max96W/class_d_amp/README.md

# Class D amplifier
A discrete class D amplifier able to deliver 300 W into 4 Ohms

For further information please read docu.pdf/odt. Note that the design is not fully tested yet so do not expect it to work out of the box if you like to build it.
