max96W/class_d_amp/classD.pdf

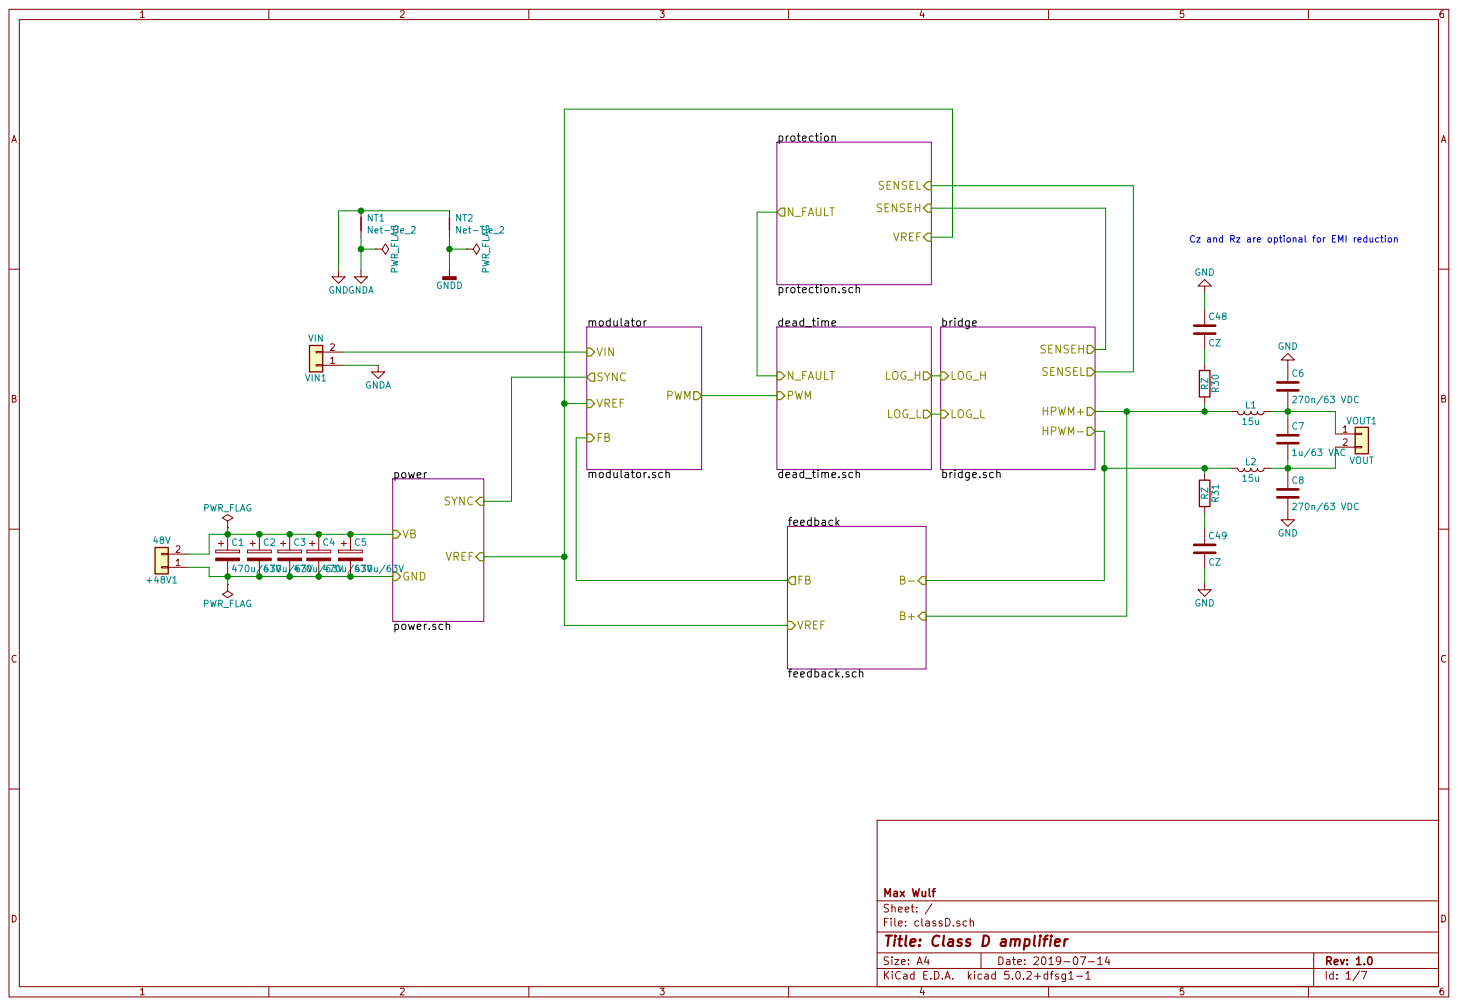
[picture p1: page 1]

Id: 1/7 Title: Class D amplifier File: classD.sch Sheet: / Max Wulf modulator modulator.sch VIN
power power.sch VREF VBGND

1u/63 VAC GND GND GNDA

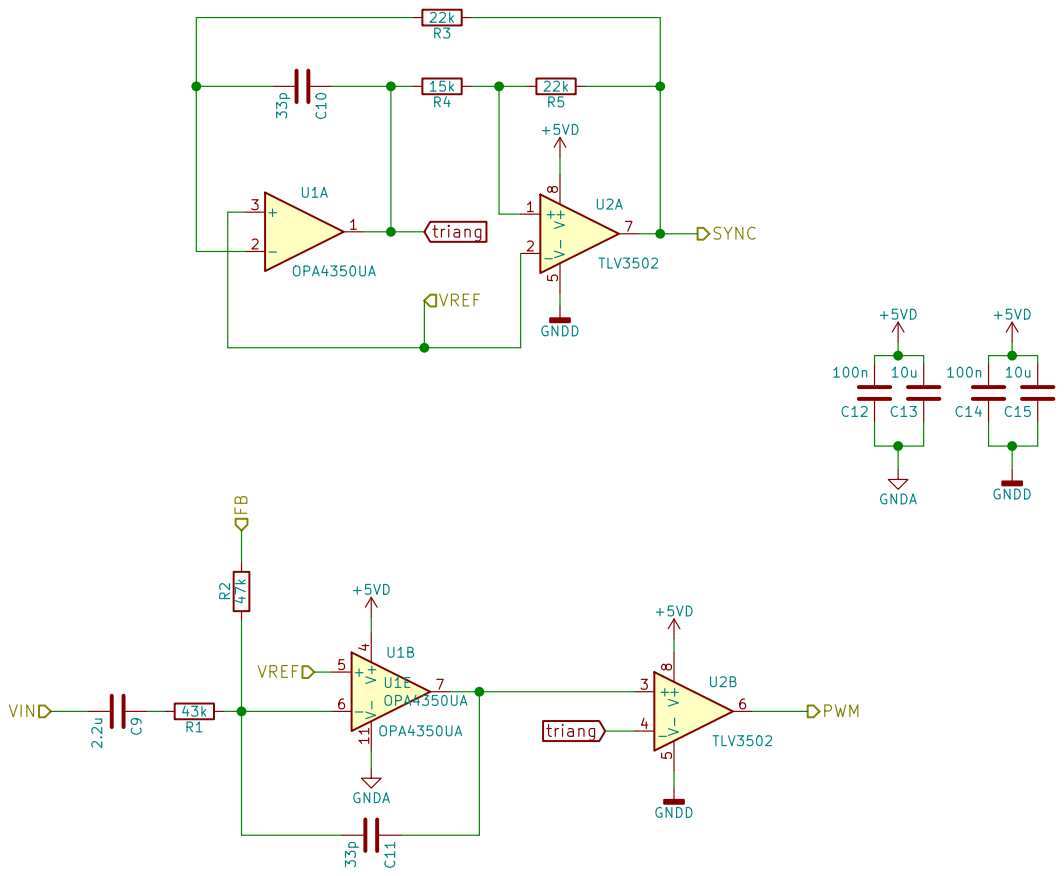
[picture p2: page 2]

Id: 2/7 Title: Class D amplifier File: modulator.sch Sheet: /modulator/ Max Wulf

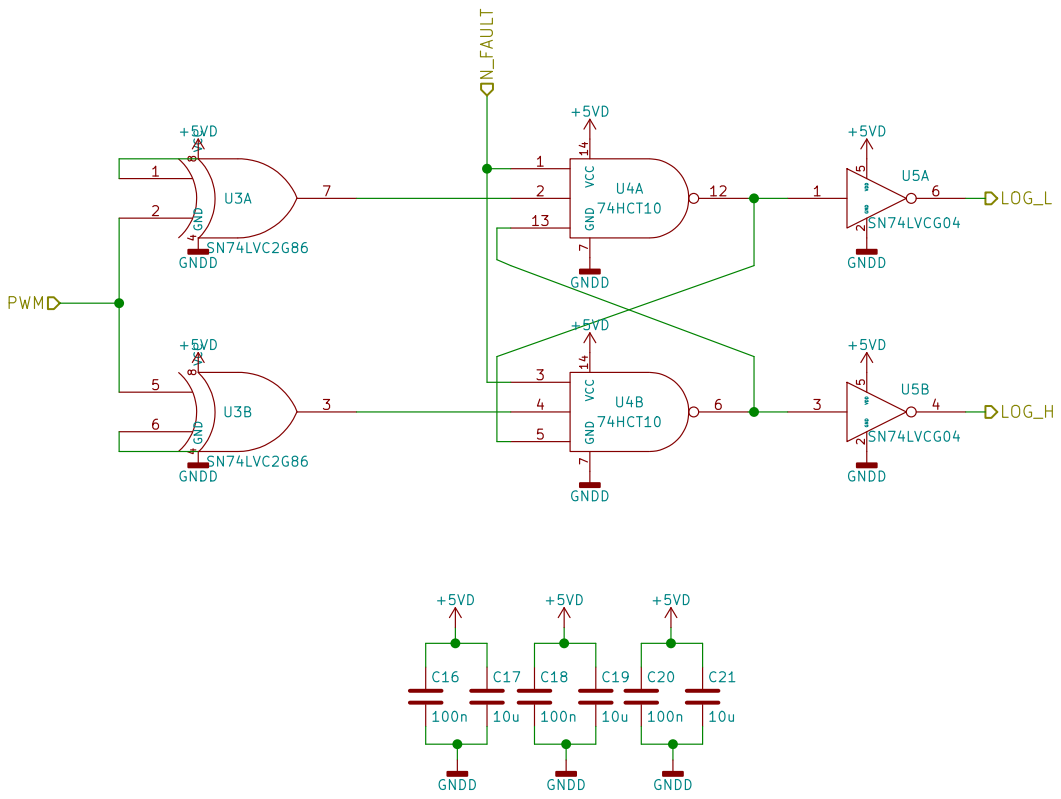
[picture p3: page 3]

File: dead_time.sch
Id: 3/7 Title: Class D amplifier

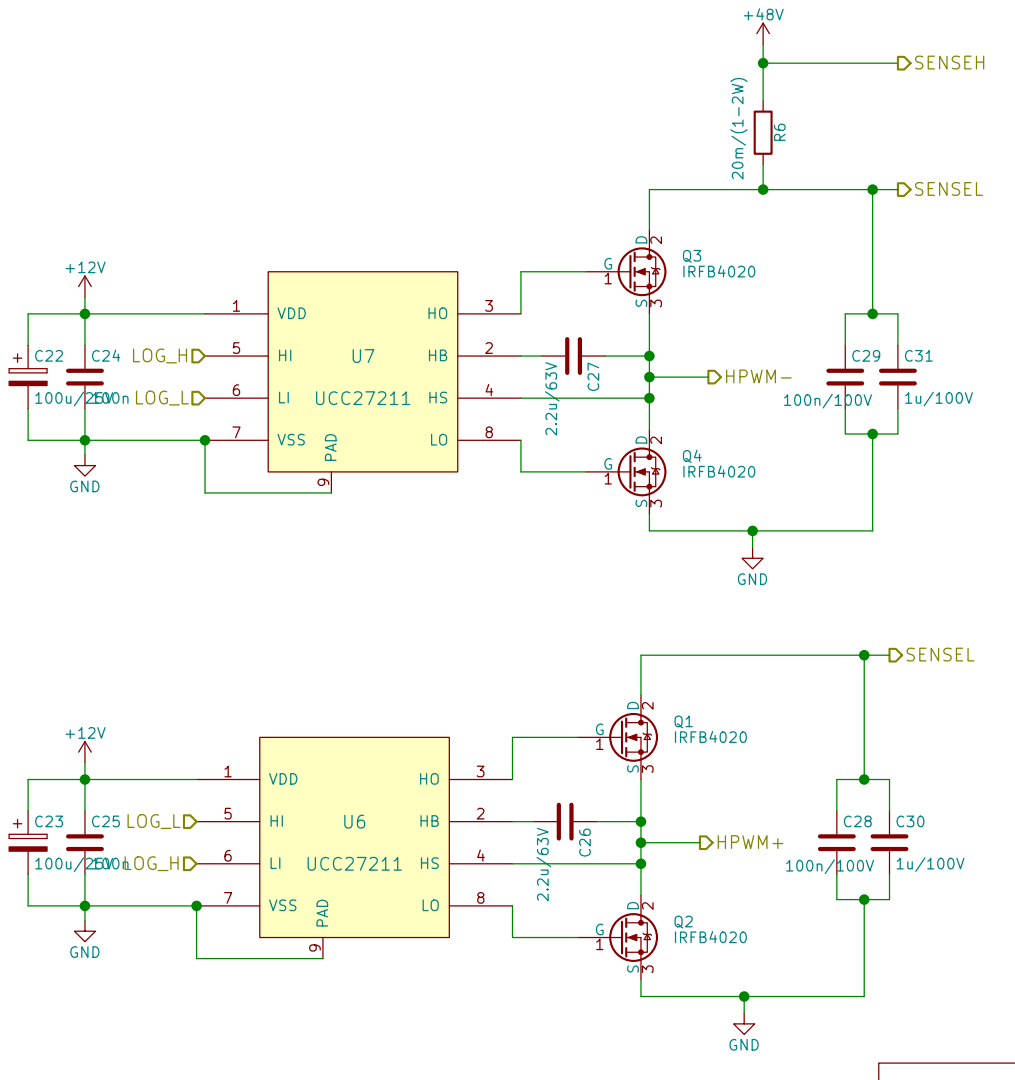
[picture p4: page 4]

Sheet: /bridge/ Max Wulf

File: bridge.sch
Id: 4/7 Title: Class D amplifier

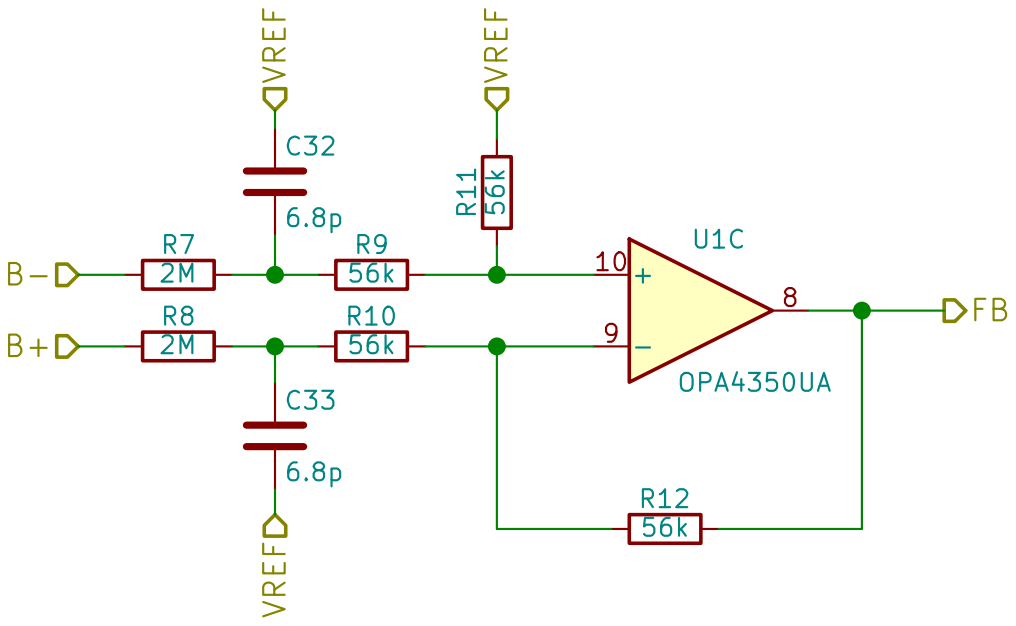
[picture p5: page 5]

Id: 5/7 Title: Class D amplifier File: feedback.sch Sheet: /feedback/ Max Wulf

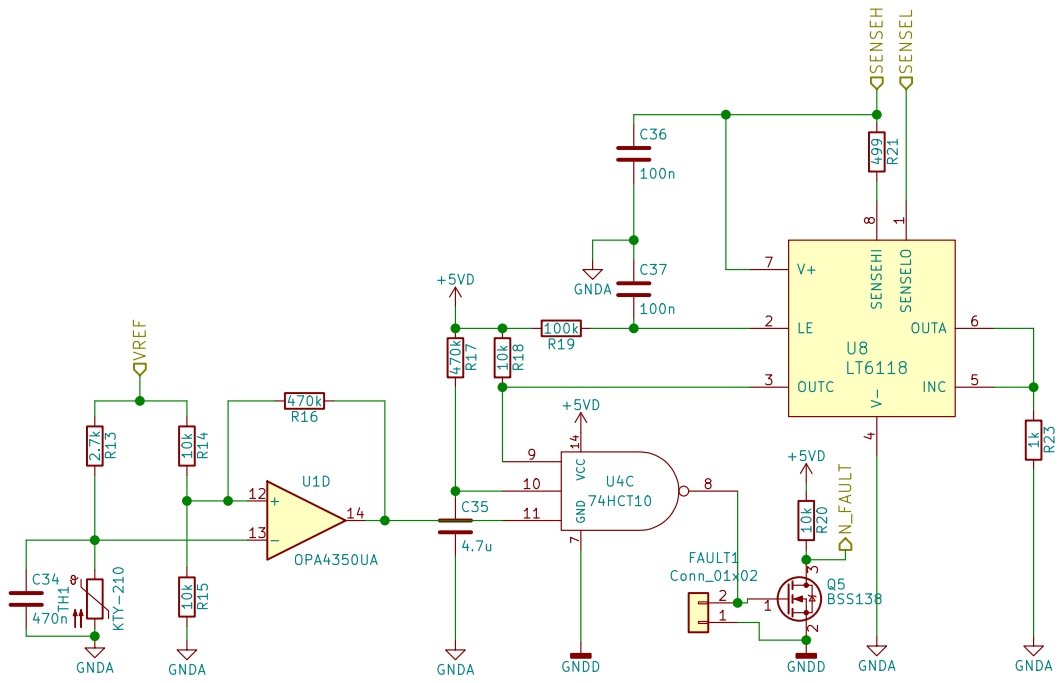
[picture p6: page 6]

File: protection.sch
Id: 6/7 Title: Class D amplifier

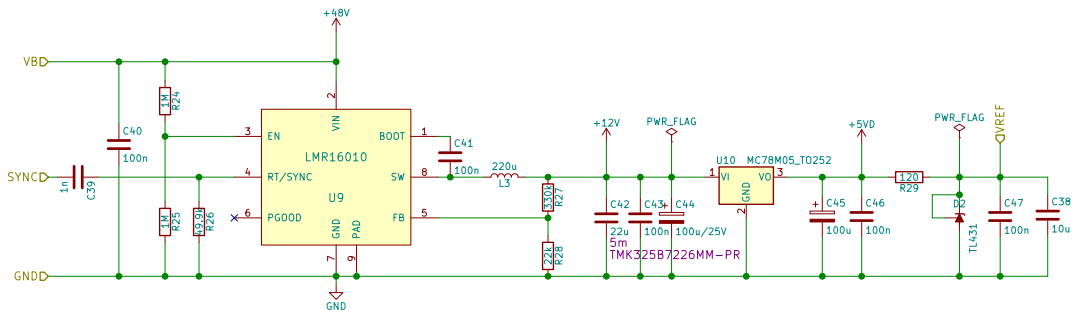
[picture p7: page 7]

2 EN 3 RT/SYNC 4 FB 5 PGOOD 6 GND

Sheet: /power/ Max Wulf

File: power.sch
Id: 7/7 Title: Class D amplifier
