max96W/class_d_amp/spice/complete/complete.asc

C1: cap; 4.7µ
C2: cap; 4.7µ
C3: cap; 2.2µ
C4: cap; 33p
C7: cap; {CF}
C8: cap; {CF1}
C9: cap; {CF1}
C10: cap; 270n
C11: cap; 1µ; V=50 Irms=0 Rser=0.008 Lser=0
C12: cap; 270n
L3: ind; 15µ
L4: ind; 15µ
M1: nmos; IRFB4020
M2: nmos; IRFB4020
M3: nmos; IRFB4020
M4: nmos; IRFB4020
R1: res; 1
R2: res; 1
R3: res; 1
R4: res; 1
R5: res; 1k
R6: res; 43k
R7: res; {RF}
R8: res; {RF1}
R9: res; {RF2}
R10: res; {RF3}
R11: res; {RF3}
R12: res; {RF2}
R13: res; {RF1}
R14: res; 4; tol=10 pwr=500
R15: res; 22k
R16: res; 15k
R18: res; 22k
U1: LT1720
U2: opamp2; OPA350
U3: LT1720
U4: 74hct10
U5: 74hct86
U6: UCC27211
U7: UCC27211
U8: LT6221
U9: LT6221
U10: 74hct04
U11: 74hct04
U12: 74hct86
U13: 74hct10
V1: voltage; 5
V2: voltage; 2.5
V4: voltage; SINE(0 980m 1k 0 0 0)
V5: voltage; 12
V6: voltage; 50
V7: voltage; PULSE(0 5 20u 10n)
Named nets: +5V, 2.5V_ref, 0, LOG_L, LOG_H, vo+, vo-, +12V, +50V, N_FAULT, triang
.include ../../libs/IRFB4020.LIB
.include ../../libs/OPA350.LIB
.include ../../libs/UCC27211.LIB
.tran 0 11m 0 100u uic
.lib cd4000.lib
.param RF1=2Meg RF2=56k CF1=6.8p RF3=56k CF=150p RF=47k
.lib 74hct.lib
.ic v(n012)=2.5 v(n005)=2.5 v(n018)=25 v(n013)=25 v(n001)=2.5 v(n020)=2.45
.four 1k 10 I(R14)
inverters are sn74lvc2g04
.ic  i(L3)=0 I(L4)=0
