max96W/class_d_amp/spice/linear_model/linear_model_cl.asc

C1: cap; 2.2µ
C2: cap; {CF}
C3: cap; 270n
C4: cap; 1µ; V=50 Irms=0 Rser=0.008 Lser=0
C5: cap; 270n
C6: cap; {CF1}
C7: cap; {CF1}
E1: e; 10
E2: e; -10
E3: e; -1
E4: e; 1.43
L1: ind; 15µ
L2: ind; 15µ
R1: res; 43k
R2: res; {RF}
R3: res; 4; tol=10 pwr=500
R4: res; {RF1}
R5: res; {RF2}
R6: res; {RF3}
R7: res; {RF3}
R8: res; {RF2}
R9: res; {RF1}
U3: opamp2; OPA350
U4: opamp2; OPA350
V1: voltage; 5
V2: voltage; 2.5
V4: voltage; SINE(2.5 1 1k 0 0 0); AC 1
V5: voltage; 25
V6: voltage; 25
Named nets: 0, +5V, 2.5V_ref, vout
.include ../../libs/74HCT.LIB
.include ../../libs/IRFB4020.LIB
.include ../../libs/OPA350.LIB
;tran 0 11m 0 100u uic
.lib cd4000.lib
;.ic v(n005)=25 v(n002)=25 v(n001)=2.5 v(n011)=2.5 v(n010)=2.5
.param RF1=2Meg RF2=56k CF1=6.8p RF3=56k CF=150p RF=47k
.ac dec 50 1 10Meg
.ic v(n005)=2.5 v(n009)=2.5
