max96W/class_d_amp/spice/oszillator/oscillator.asc

C1: cap; 33p
R1: res; 22k
R2: res; 15k
R3: res; 22k
U1: LT1720
U2: opamp2; OPA350
V1: voltage; 5; Rser=0
V3: voltage; 2.5; Rser=0
Named nets: 0, triang
.tran 0 110u 100u 10u startup uic
.include ../../libs/OPA350.LIB
