max96W/class_d_amp/spice/otp/otp.asc

B1: bi; I=(V(op+)/(2k+15.8*(v(vth)-25)))
B2: bv; V=V(OP+)/I(B1)
C1: cap; 470n
R2: res; 470k
R3: res; 10k
R4: res; 10k
R5: res; 2.7k
U1: opamp2; OPA350
V1: voltage; 5
V2: voltage; 2.5
V3: voltage; PULSE(0 150 0 1 1 0 2)
Named nets: +5V, 0, 2.5V_ref, otp, vth, op+, R
.tran 0 4 0 1m startup uic
.include ../../libs/OPA350.LIB
