max96W/class_d_amp/spice/ringing/ringing.asc

C1: cap; 4.7µ
C2: cap; 4.7µ
C3: cap; 2.2µ
C4: cap; 33p
C5: cap; 10n
C6: cap; 100n
C7: cap; {CF}
C8: cap; {CF1}
C9: cap; {CF1}
C10: cap; 270n
C11: cap; 1µ; V=50 Irms=0 Rser=0.008 Lser=0
C12: cap; 270n
C13: cap; 150p
C14: cap; 100n
C15: cap; 2.2µ
D1: diode; 1N4148
E1: e; 1
L2: ind; 30n
L3: ind; 15µ
L4: ind; 15µ
M1: nmos; IRFB4020
M2: nmos; IRFB4020
M3: nmos; IRFB4020
M4: nmos; IRFB4020
R1: res; 10m
R2: res; 10m
R3: res; 10m
R4: res; 10m
R6: res; 43k
R7: res; {RF}
R8: res; {RF1}
R9: res; {RF2}
R10: res; {RF3}
R11: res; {RF3}
R12: res; {RF2}
R13: res; {RF1}
R14: res; 4
R15: res; 22k
R16: res; 15k
R17: res; 20m; pwr=5
R18: res; 22k
R19: res; 10m
R20: res; 560
R21: res; 10k
R22: res; 8k
R23: res; 820
R24: res; 10k
R25: res; 10k
R26: res; 1.5Meg
S1: sw; MYSW
U1: LT1720
U2: opamp2; OPA350
U3: LT1720
U4: 74hct10
U5: 74hct86
U6: UCC27211
U7: UCC27211
U8: opamp2; OPA350
U9: opamp2; OPA350
U10: 74hct04
U11: 74hct04
U12: 74hct86
U13: 74hct10
U14: LT6118
U15: 74hct08
V1: voltage; 5
V2: voltage; 2.5
V3: voltage; PULSE(0 5 250u 10n 10n)
V4: voltage; SINE(0 1 1k 0 0 0); Rser=2.2k
V5: voltage; 12
V6: voltage; 50
Named nets: +5V, 2.5V_ref, 0, LOG_L, LOG_H, vo+, vo-, +12V, +50V, N_FAULT, triang, vo, SENSE_H, SENSE_L, LE, o+, o-
.include ../../libs/IRFB4020.LIB
.include ../../libs/OPA350.LIB
.include ../../libs/UCC27211.LIB
.tran 0 1m 0 10u uic
.lib cd4000.lib
.param RF1=2Meg RF2=56k CF1=6.8p RF3=56k CF=150p RF=47k
.lib 74hct.lib
.four 1k 10 v(vo)
inverters are sn74lvc2g04
;savebias bias.txt internal time=998u
.loadbias bias.txt
.model MYSW SW(Ron=1Meg Roff=10Meg Vt=.5 Vh=-.4)
