max96W/class_d_amp/spice/startup/startup.asc

C1: cap; 2.2µ
C2: cap; 10µ
C3: cap; 100n
D1: diode; 1N4148
R1: res; 1Meg
R6: res; 10k
S1: sw; MYSW
U1: 74hct08
V1: voltage; 5
V2: voltage; PULSE(5 0 1 10n 10n 1 11)
Named nets: 0, out
.lib 74hct.lib
.model MYSW SW(Ron=1 Roff=10Meg Vt=.5 Vh=-.4)
.tran 0 100 0 1 startup uic
