max96W/class_d_amp/kicad/classD.kicad_pcb

## KiCad design kicad/classD.kicad_pcb (2019-07-14)

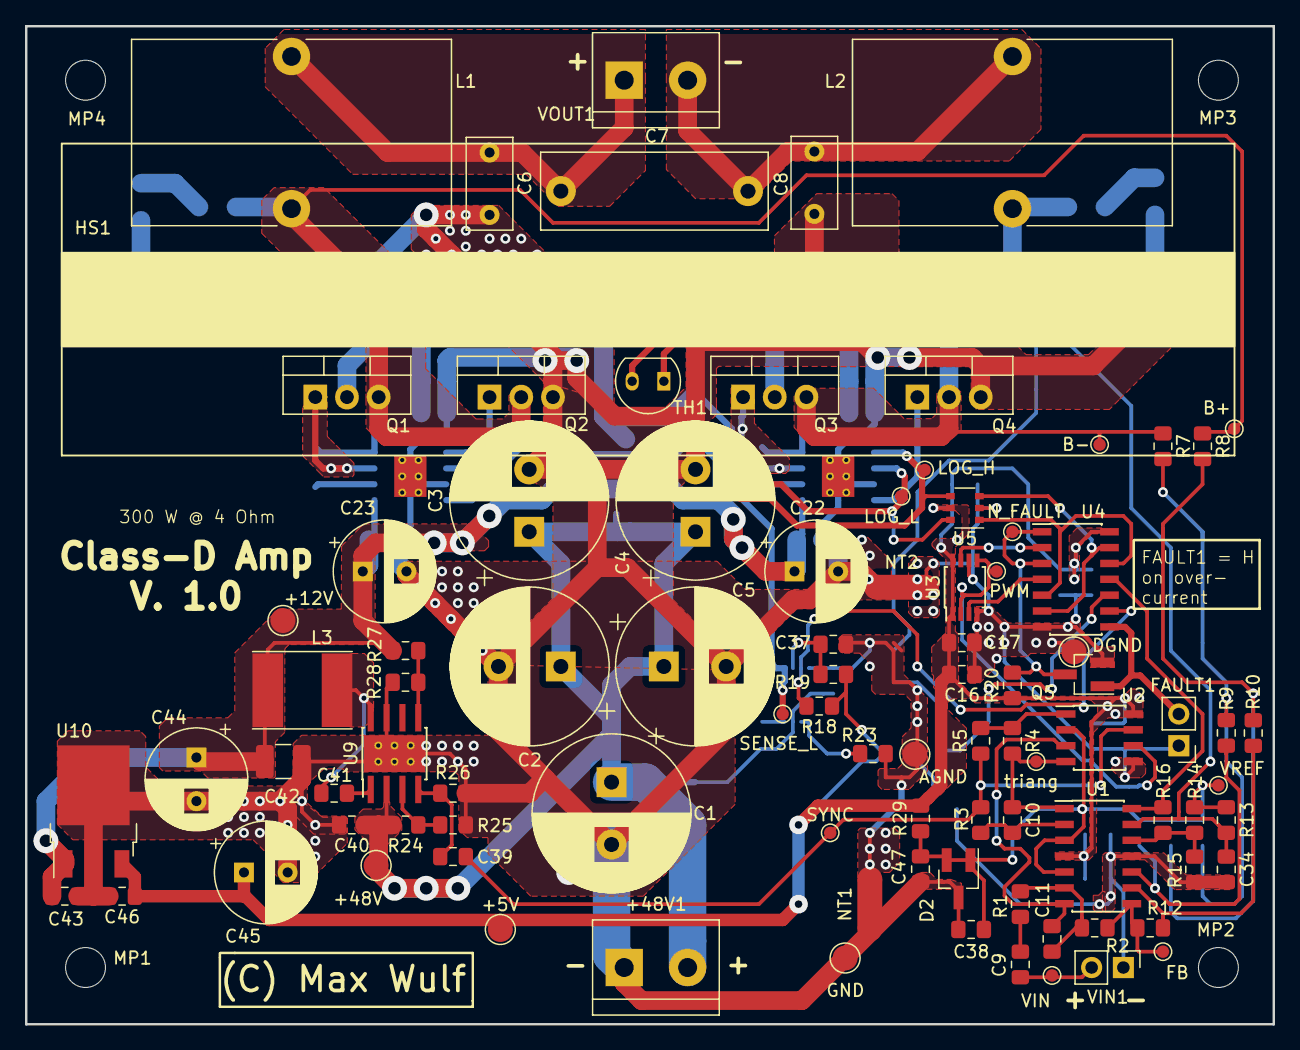
[picture p8: board classD.kicad_pcb from above]

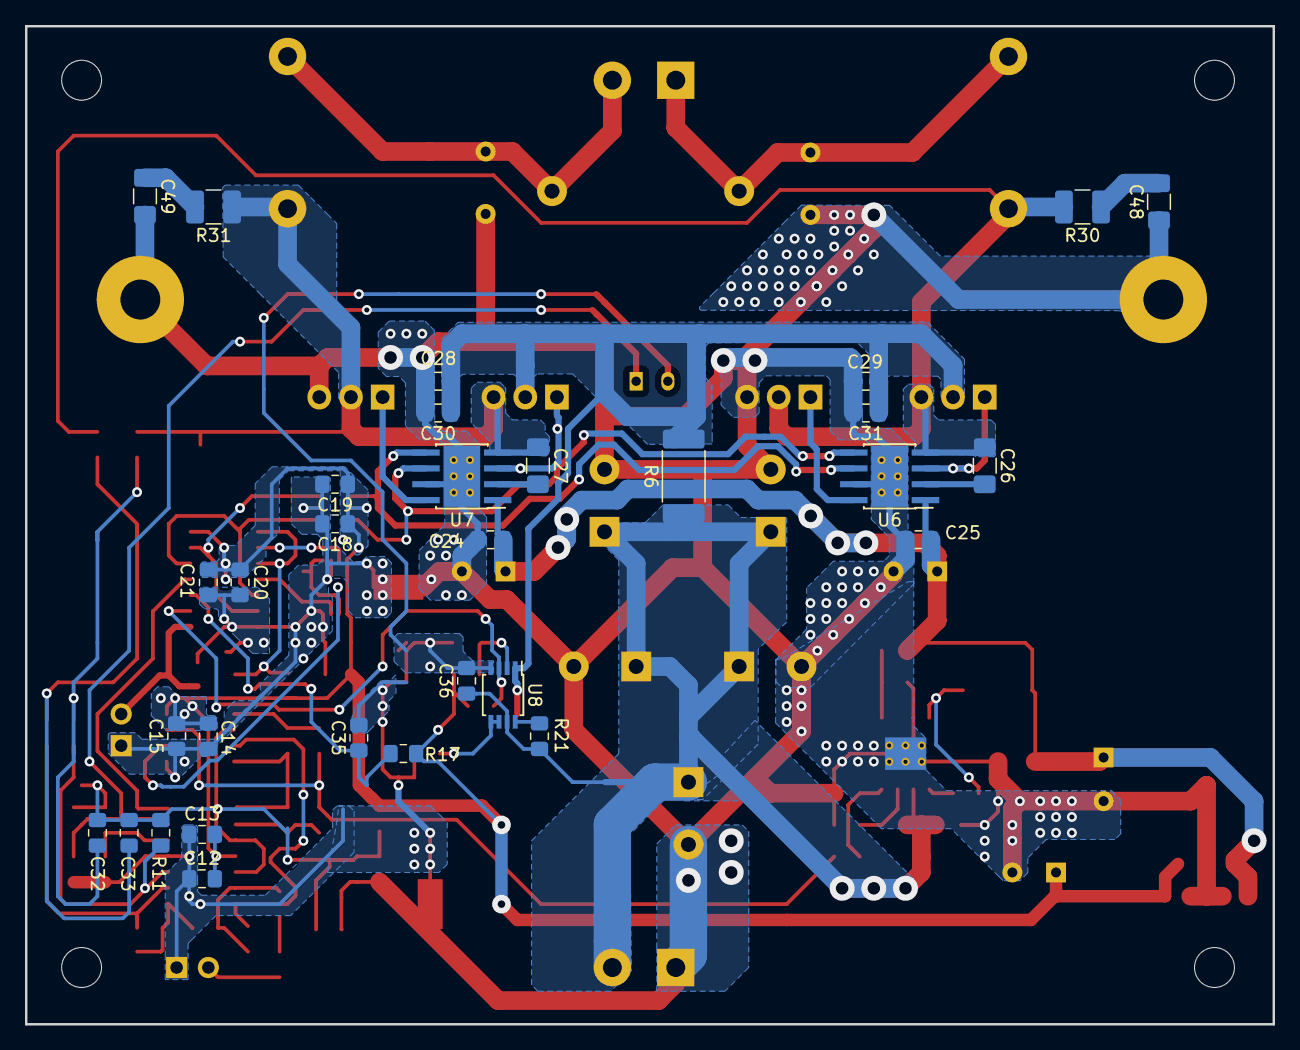
[picture p9: board classD.kicad_pcb from below]

Board: 2 copper layers, 100.0 x 80.0 mm, 128 parts (31 on the bottom side), 55 nets.

Parts:
+5V, +12V, +48V: TestPoint_Pad_D2.0mm
+48V1: 48V; TerminalBlock_bornier-2_P5.08mm
AGND: TestPoint_Pad_D2.0mm
B+: TestPoint_Pad_D1.0mm
B-: TestPoint_Pad_D1.0mm
C1, C2, C3, C4, C5: 470u/63V; CP_Radial_D12.5mm_P5.00mm
C6, C8: 270n/63 VDC; C_Rect_L7.2mm_W3.5mm_P5.00mm_FKS2_FKP2_MKS2_MKP2
C7: 1u/63 VAC; C_Rect_L18.0mm_W6.0mm_P15.00mm_FKS3_FKP3
C9: 2.2u; C_0805_2012Metric_Pad1.15x1.40mm_HandSolder
C10, C11: 33p; C_0805_2012Metric_Pad1.15x1.40mm_HandSolder
C12, C14, C16, C18, C20, C24, C25, C36, C37, C40, C41, C43, C46, C47: 100n; C_0805_2012Metric_Pad1.15x1.40mm_HandSolder
C13, C15, C17, C19, C21, C38: 10u; C_0805_2012Metric_Pad1.15x1.40mm_HandSolder
C22, C23, C44: 100u/25V; CP_Radial_D8.0mm_P3.50mm
C26, C27: 2.2u/63V; C_1206_3216Metric_Pad1.42x1.75mm_HandSolder
C28, C29: 100n/100V; C_0805_2012Metric_Pad1.15x1.40mm_HandSolder
C30, C31: 1u/100V; C_0805_2012Metric_Pad1.15x1.40mm_HandSolder
C32, C33: 6.8p; C_0805_2012Metric_Pad1.15x1.40mm_HandSolder
C34: 470n; C_0805_2012Metric_Pad1.15x1.40mm_HandSolder
C35: 4.7u; C_0805_2012Metric_Pad1.15x1.40mm_HandSolder
C39: 1n; C_0805_2012Metric_Pad1.15x1.40mm_HandSolder
C42: 22u; C_1210_3225Metric_Pad1.42x2.65mm_HandSolder
C45: 100u; CP_Radial_D8.0mm_P3.50mm
C48, C49: CZ; C_1206_3216Metric_Pad1.42x1.75mm_HandSolder
D2: TL431; SOT-23_Handsoldering
DGND: TestPoint_Pad_D2.0mm
FAULT1: Conn_01x02; PinHeader_1x02_P2.54mm_Vertical
FB: TestPoint_Pad_D1.0mm
GND: TestPoint_Pad_D2.0mm
HS1: ALUTRONIC_PR118-94-SE-M3
L1, L2: 15u; L_Toroid_Vertical_L25.4mm_W14.7mm_P12.20mm_Vishay_TJ5_BigPa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
L3: 220u; L_Taiyo-Yuden_NR-60xx_HandSoldering
LOG_H: TestPoint_Pad_D1.0mm
LOG_L: TestPoint_Pad_D1.0mm
MP1, MP2, MP3, MP4: MountingHole_3.2mm_M3
NT1, NT2: Net-Tie_2; NetTie-2_SMD_Pad2.0mm
N_FAULT: TestPoint_Pad_D1.0mm
PWM: TestPoint_Pad_D1.0mm
Q1, Q2, Q3, Q4: IRFB4020; TO-220-3_Vertical
Q5: BSS138; SOT-23_Handsoldering
R1: 43k; R_0805_2012Metric_Pad1.15x1.40mm_HandSolder
R2: 47k; R_0805_2012Metric_Pad1.15x1.40mm_HandSolder
R3, R5, R28: 22k; R_0805_2012Metric_Pad1.15x1.40mm_HandSolder
R4: 15k; R_0805_2012Metric_Pad1.15x1.40mm_HandSolder
R6: 20m/(1-2W); R_2512_6332Metric_Pad1.52x3.35mm_HandSolder
R7, R8: 2M; R_0805_2012Metric_Pad1.15x1.40mm_HandSolder
R9, R10, R11, R12: 56k; R_0805_2012Metric_Pad1.15x1.40mm_HandSolder
R13: 2.7k; R_0805_2012Metric_Pad1.15x1.40mm_HandSolder
R14, R15, R18, R20: 10k; R_0805_2012Metric_Pad1.15x1.40mm_HandSolder
R16, R17: 470k; R_0805_2012Metric_Pad1.15x1.40mm_HandSolder
R19: 100k; R_0805_2012Metric_Pad1.15x1.40mm_HandSolder
R21: 499; R_0805_2012Metric_Pad1.15x1.40mm_HandSolder
R23: 1k; R_0805_2012Metric_Pad1.15x1.40mm_HandSolder
R24, R25: 1M; R_0805_2012Metric_Pad1.15x1.40mm_HandSolder
R26: 49.9k; R_0805_2012Metric_Pad1.15x1.40mm_HandSolder
R27: 330k; R_0805_2012Metric_Pad1.15x1.40mm_HandSolder
R29: 120; R_0805_2012Metric_Pad1.15x1.40mm_HandSolder
R30, R31: RZ; R_1210_3225Metric_Pad1.42x2.65mm_HandSolder
SENSE_L: TestPoint_Pad_D1.0mm
SYNC: TestPoint_Pad_D1.0mm
TH1: KTY-210; TO-92-2
U1: OPA4350UA; SOIC-14_3.9x8.7mm_P1.27mm
U2: TLV3502; SOIC-8_3.9x4.9mm_P1.27mm
U3: SN74LVC2G86; TSSOP-8_3x3mm_P0.65mm
U4: 74HCT10; SOIC-14_3.9x8.7mm_P1.27mm
U5: SN74LVCG04; TSOP-6_1.65x3.05mm_P0.95mm
U6, U7: UCC27211; Texas_HTSOP-8-1EP_3.9x4.9mm_P1.27mm_EP2.95x4.9mm_Mask2.4x3.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
U8: LT6118; TSSOP-8_3x3mm_P0.65mm
U9: LMR16010; Texas_HTSOP-8-1EP_3.9x4.9mm_P1.27mm_EP2.95x4.9mm_Mask2.4x3.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
U10: MC78M05_TO252; TO-252-2
VIN: TestPoint_Pad_D1.0mm
VIN1: VIN; PinHeader_1x02_P2.54mm_Vertical
VOUT1: VOUT; TerminalBlock_bornier-2_P5.08mm
VREF: TestPoint_Pad_D1.0mm
triang: TestPoint_Pad_D1.0mm

Connections:
+5VD: +5V.1, C12.2, C13.2, C14.2, C15.2, C16.1, C17.1, C18.1, C19.1, C20.1, C21.1, C45.1, C46.1, R17.1, R18.1, R19.2, R20.1, R29.2, U1.4, U2.8, U3.1, U3.8, U4.14, U5.5, U10.3
+12V: +12V.1, C22.1, C23.1, C24.1, C25.1, C42.1, C43.1, C44.1, L3.2, R27.1, U6.1, U7.1, U10.1
+48V: +48V.1, +48V1.2, C1.1, C2.1, C3.1, C4.1, C5.1, C36.1, C40.1, R6.1, R21.1, R24.1, U8.7, U9.2
/bridge/LOG_H: LOG_H.1, U5.4, U6.6, U7.5
/bridge/LOG_L: LOG_L.1, U5.6, U6.5, U7.6
/bridge/SENSEL: C28.1, C29.1, C30.1, C31.1, Q1.2, Q3.2, R6.2, SENSE_L.1, U8.1
/dead_time/N_FAULT: N_FAULT.1, Q5.3, R20.2, U4.1, U4.3
/dead_time/PWM: PWM.1, U2.6, U3.2, U3.5
/feedback/B+: B+.1, C26.1, L1.2, Q1.3, Q2.2, R8.1, R30.2, U6.4
/feedback/B-: B-.1, C27.1, L2.2, Q3.3, Q4.2, R7.1, R31.1, U7.4
/feedback/FB: FB.1, R2.2, R12.2, U1.8
/feedback/VREF: C32.1, C33.2, C38.1, C47.1, D2.1, D2.2, R11.2, R13.1, R14.1, R29.1, U1.3, U1.5, U2.2, VREF.1
/modulator/SYNC: C39.2, R3.1, R5.1, SYNC.1, U2.7
/modulator/VIN: C9.2, VIN.1, VIN1.2
GND: +48V1.1, C1.2, C2.2, C3.2, C4.2, C5.2, C6.1, C8.2, C22.2, C23.2, C24.2, C25.2, C28.2, C29.2, C30.2, C31.2, C38.2, C40.2, C42.2, C43.2, C44.2, C45.2, C46.2, C47.2, C48.1, C49.2, D2.3, GND.1, HS1.1, NT1.1, NT2.1, Q2.3, Q4.3, R25.2, R26.2, R28.2, U6.7, U6.9, U7.7, U7.9, U9.7, U9.9, U10.2
GNDA: AGND.1, C12.1, C13.1, C34.2, C35.2, C36.2, C37.1, NT1.2, R15.2, R23.2, TH1.2, U1.11, U8.4, VIN1.1
GNDD: C14.1, C15.1, C16.2, C17.2, C18.2, C19.2, C20.2, C21.2, DGND.1, FAULT1.1, NT2.2, Q5.2, U2.5, U3.4, U3.6, U4.7, U5.2
unnamed: C6.2, C7.1, L1.1, VOUT1.1
unnamed: C7.2, C8.1, L2.1, VOUT1.2
unnamed: C9.1, R1.2
unnamed: C10.2, R3.2, U1.2
unnamed: C11.1, U1.7, U2.3
unnamed: C11.2, R1.1, R2.1, U1.6
unnamed: C26.2, U6.2
unnamed: C27.2, U7.2
unnamed: C32.2, R7.2, R9.1
unnamed: C33.1, R8.2, R10.1
unnamed: C34.1, R13.2, TH1.1, U1.13
unnamed: C35.1, R17.2, U4.10
unnamed: C37.2, R19.1, U8.2
unnamed: C39.1, R26.1, U9.4
unnamed: C41.1, U9.1
unnamed: C41.2, L3.1, U9.8
unnamed: C48.2, R30.1
unnamed: C49.1, R31.2
unnamed: FAULT1.2, Q5.1, U4.8
unnamed: Q1.1, U6.3
unnamed: Q2.1, U6.8
unnamed: Q3.1, U7.3
unnamed: Q4.1, U7.8
unnamed: R4.1, R5.2, U2.1
unnamed: R10.2, R12.1, U1.9
unnamed: R9.2, R11.1, U1.10
unnamed: R14.2, R15.1, R16.2, U1.12
unnamed: R16.1, U1.14, U4.11
unnamed: R18.2, U4.9, U8.3
unnamed: R21.2, U8.8
unnamed: R23.1, U8.5, U8.6
unnamed: R24.2, R25.1, U9.3
unnamed: R27.2, R28.1, U9.5
unnamed: U3.3, U4.4
unnamed: U3.7, U4.2
unnamed: U4.5, U4.12, U5.1
unnamed: U4.6, U4.13, U5.3
triang: C10.1, R4.2, U1.1, U2.4, triang.1
